specs32/prolight/README.md

# prolight
Gyroscope Matrix Flashlight

click the wiki button in the menu above ! ;)
