specs32/prolight/REV11/BLENDER/btncap_array_good_1.stl

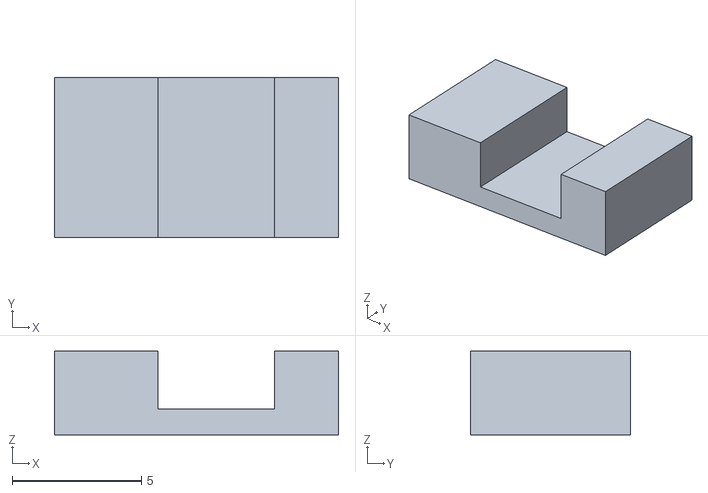
[picture p1: CAD file, 2018-05-02, an earlier design]
REV11/BLENDER/btncap_array_good_1.stl
11.0 x 6.20 x 3.25
