specs32/prolight/REV11/BLENDER/prolight25.stl

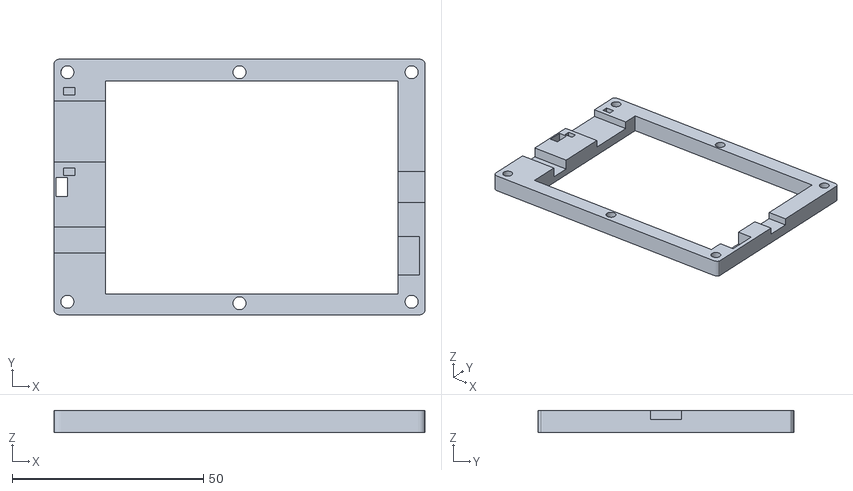
[picture p2: CAD file, 2018-05-02, an earlier design]
REV11/BLENDER/prolight25.stl
97.0 x 67.0 x 5.80
