specs32/prolight/(list of files, cad)

Other CAD files:
REV11/BLENDER/prolight25.blend
REV14/BLENDER/prolight27_w_buttons.blend
