specs32/prolight/REV14/changelog.md

//////////////////////////////////
changelog for the prolight REV 14 
//////////////////////////////////

- PE2 button removed - 3 way switch removed because of bad bad quality. (replaced with two good micro switches.) 

- oled circuit fixed and repositioned

- power mosfets fixed
