specs32/prolight/REV11/KICAD/eside_rev11/pdf/modular_eside_rev11.pdf

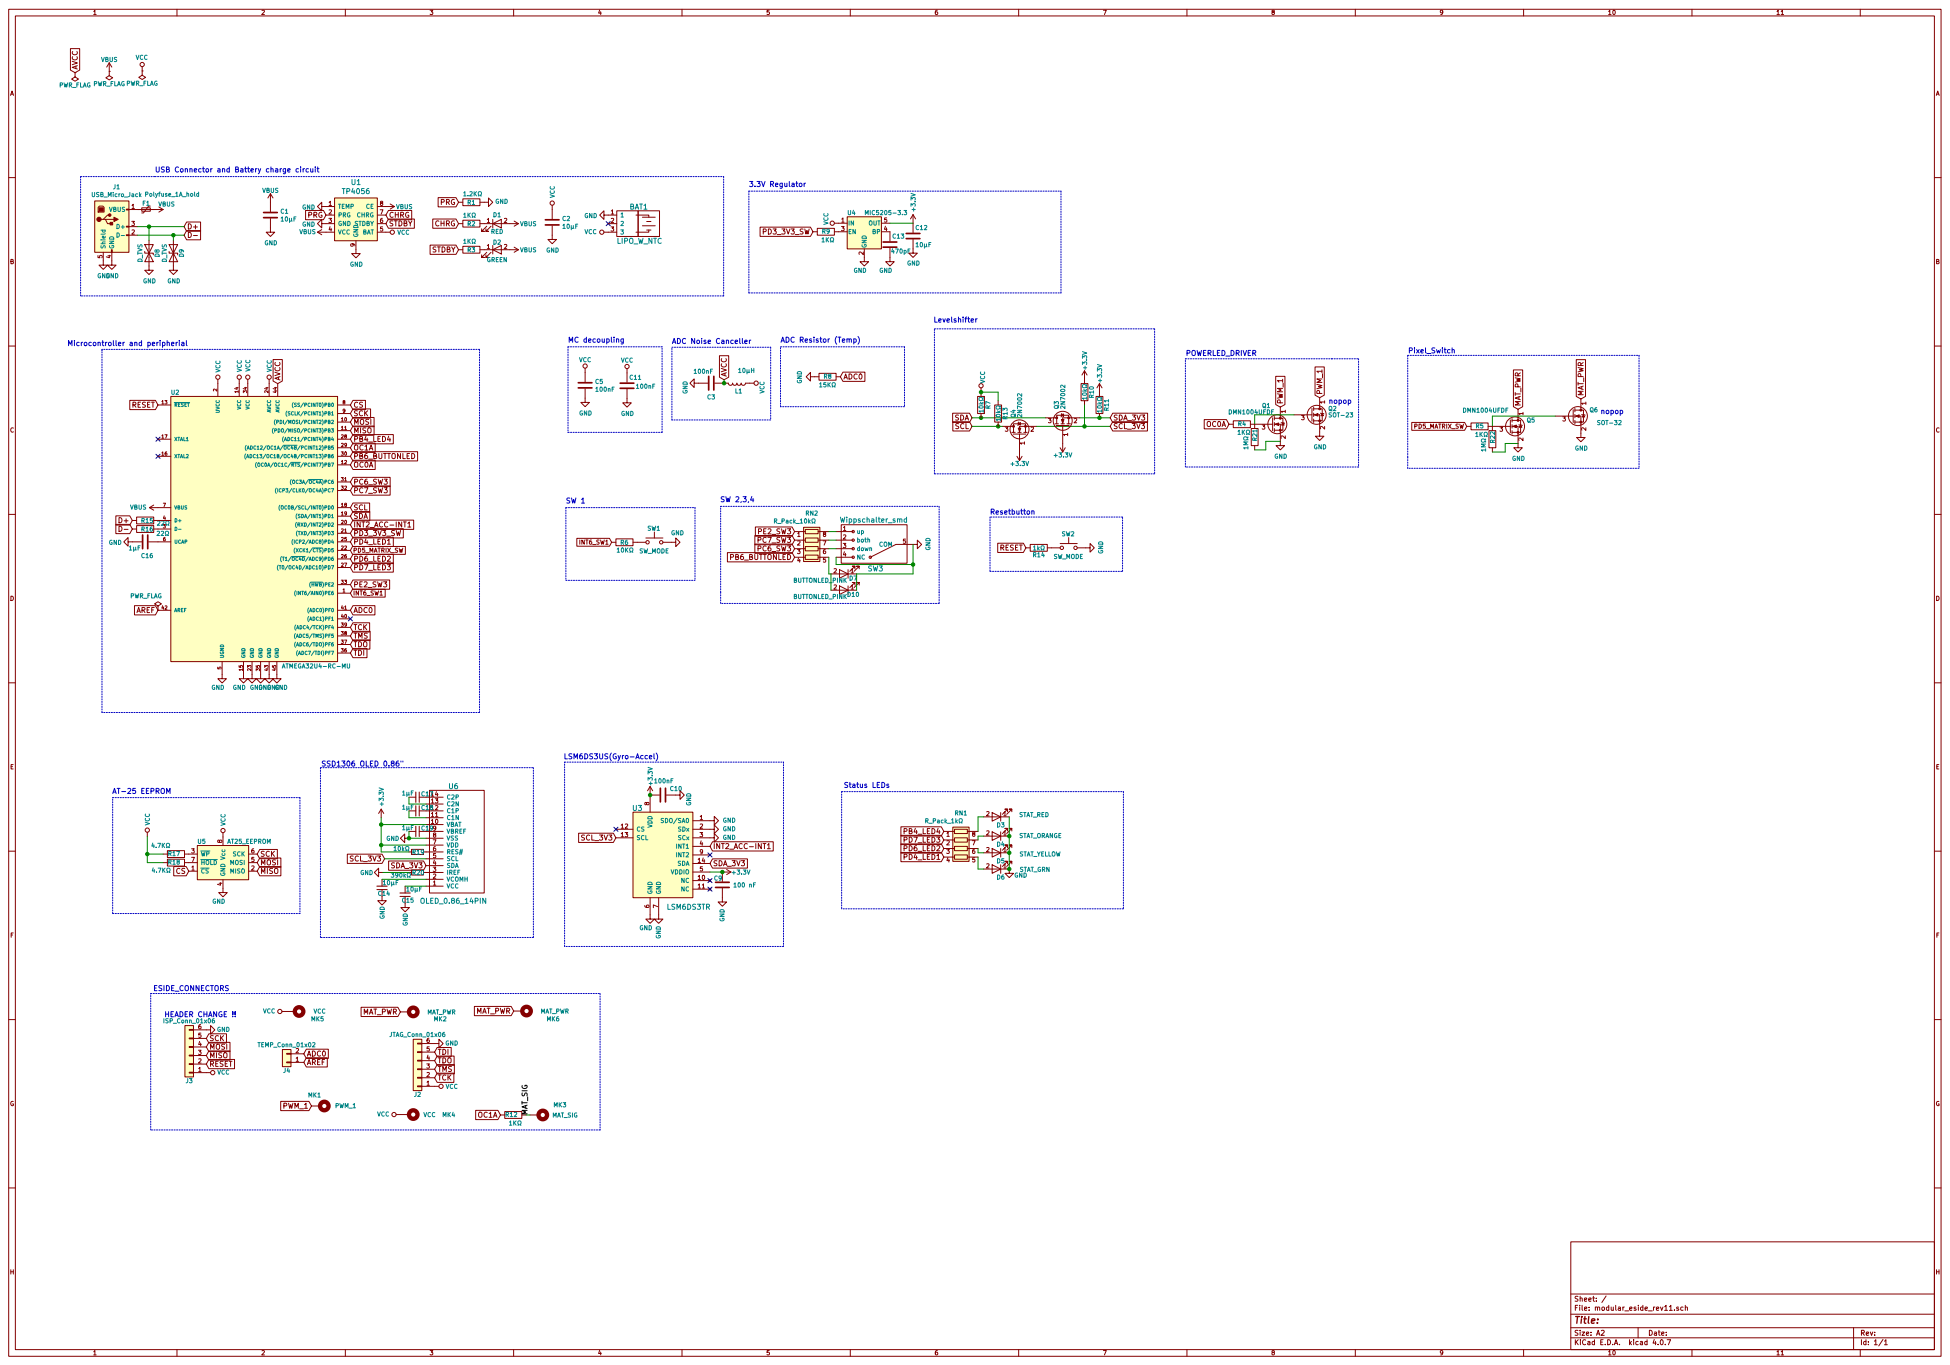
[picture p3: page 1]
