specs32/prolight/REV14/KICAD/eside_rev14/modular_eside_rev14.kicad_pcb

## KiCad design REV14/KICAD/eside_rev14/modular_eside_rev14.kicad_pcb (2018-05-02)

Schematic: modular_eside_rev14.sch

Parts:
BAT1: LIPO_W_NTC; CONN_AVX_RT_ANGLE_3pin_2.5mm_pitch
C1, C2, C12: 10µF; C_0805_HandSoldering
C3: 100nF; C_0805_HandSoldering
C4, C6, C14: 4.7µF; C_0805_HandSoldering
C5, C7, C10, C11, C18: 100nF; C_0603_HandSoldering
C8: 2.2µF; C_0805_HandSoldering
C9: 100 nF; C_0603_HandSoldering
C13: 470pF; C_0603_HandSoldering
C15, C16, C17: 1µF; C_0805_HandSoldering
D1: RED; LED_0603_HandSoldering
D2: GREEN; LED_0603_HandSoldering
D3: STAT_RED; LED_0603_HandSoldering
D4: STAT_YELLOW; LED_0603_HandSoldering
D5: STAT_GREEN; LED_0603_HandSoldering
D6: STAT_PINK; LED_0603_HandSoldering
D7, D10: BUTTONLED_PINK; LED_0603_HandSoldering
D8, D9: D_TVS; C_0603_HandSoldering
D11: LL4148; D_MiniMELF
F1: Polyfuse_1A_hold; C_0805_HandSoldering
J1: USB_Micro_Jack; Conn_USBmicro-B_ebay-side_TH_GROUND
J2: JTAG_Conn_01x06; Conn_01x06_SMD_2mm
J3: ISP_Conn_01x06; Conn_01x06_SMD_2mm
J4: TEMP_Conn_01x02; Pin_Header_Straight_1x02_Pitch2.00mm
L1: 10µH; C_0805_HandSoldering
MK1: PWM_1; MountingHole_2.2mm_M2_Pad
MK2, MK6: MAT_PWR; MountingHole_2.2mm_M2_Pad
MK3: MAT_SIG; MountingHole_2.2mm_M2_Pad
MK4, MK5: VCC; MountingHole_2.2mm_M2_Pad
Q1, Q5: DMN1004UFDF; U-DFN2020-6-smallerpads
Q2, Q6: Q_NMOS_GSD; SOT-23
Q3, Q4: 2N7002; SOT-23
R1: 1.2KΩ; R_0805_HandSoldering
R2, R3, R4, R5, R9, R12, R24: 1KΩ; R_0805_HandSoldering
R6, R19, R20: 10KΩ; R_0805_HandSoldering
R7, R10, R11, R13: 10kΩ; R_0805_HandSoldering
R8: 15KΩ; R_1210_HandSoldering
R14: 1kΩ; R_0805_HandSoldering
R15, R16: 22Ω; R_0805_HandSoldering
R17, R18: 4.7KΩ; R_0805_HandSoldering
R21, R22, R23: 1MΩ; R_0805_HandSoldering
R25: 4.7kΩ; R_0805_HandSoldering
R26: 380kΩ; R_0805_HandSoldering
R27: 0Ω; R_1206_HandSoldering
RN1: R_Pack_1kΩ; R_Array_Convex_4x0603
SW1: SW_MODE; white_nano_smd_switch
SW2: SW_MODE; SW_SPST_FSMSM
SW3: SW_UP; white_nano_smd_switch
SW4: SW_DOWN; white_nano_smd_switch
U1: TP4056; SOIC-8-1EP_3.9x4.9mm_Pitch1.27mm
U2: ATMEGA32U4-RC-MU; QFN-44-1EP_7x7mm_Pitch0.5mm
U3: LSM6DS3TR; LGA-14L_2.5x3mm__LSM6DS3; MPN LSM6DS3TR; Digi-Key_PN 497-15383-1-ND
U4: MIC5205-3.3; SOT-23-5
U5: AT25_EEPROM; SOIC-8_3.9x4.9mm_Pitch1.27mm
U6: OLED_0.86_14PIN; OLED_0.86_14pin_i2c

Connections:
/MAT_SIG: MK3.1, R12.2
ADC0: J4.2, R8.2, U2.41 ((ADC0)PF0)
AREF: J4.1, U2.42 (AREF)
AVCC: C3.1, L1.2, U2.44 (AVCC)
CHRG: R2.2, U1.7
CS: U2.8 ((SS/PCINT0)PB0), U5.1 (~CS)
D+: D8.1 (A1), J1.3, R15.2
D-: D9.1 (A1), J1.2, R16.2
GND: BAT1.1, C1.2, C2.2, C3.2, C4.1, C5.2, C6.2, C7.2, C8.1, C9.2, C10.2, C11.2, C12.2, C13.2, C14.2, C16.2, C18.2, D3.1, D4.1, D5.1, D6.1, D7.1, D8.2 (A2), D9.2 (A2), D10.1, J1.4, J1.5, J2.6, J3.6, Q1.2 (S), Q2.2 (S), Q5.2 (S), Q6.2 (S), R1.1, R8.1, R21.2, R22.2, R23.2, R26.2, SW1.2, SW2.2, SW3.2, SW4.2, U1.1, U1.3, U1.9, U2.5 (UGND), U2.15 (GND), U2.23 (GND), U2.35 (GND), U2.43 (GND), U2.45 (GND), U3.1 (SDO/SA0), U3.2 (SDx), U3.3 (SCx), U3.6 (GND), U3.7 (GND), U4.2, U5.4 (GND), U6.7 (VSS)
INT2_ACC-INT1: U2.20 ((RXD/INT2)PD2), U3.4 (INT1)
INT6_SW1: R6.2, U2.1 ((INT6/AIN0)PE6)
MAT_PWR: MK2.1, MK6.1, Q5.1 (D), Q6.3 (D)
MISO: J3.3, U2.11 ((PDO/MISO/PCINT3)PB3), U5.2 (MISO)
MOSI: J3.4, U2.10 ((PDI/MOSI/PCINT2)PB2), U5.5 (MOSI)
unnamed: C4.2, R27.2, U6.9 (RES#)
unnamed: C8.2, U6.13 (VCOMH)
unnamed: C13.1, U4.4
unnamed: C14.1, C18.1, U6.14 (VCC)
unnamed: C15.1, U6.1 (C2P)
unnamed: C15.2, U6.2 (C2N)
unnamed: C16.1, U2.6 (UCAP)
unnamed: C17.1, U6.3 (C1P)
unnamed: C17.2, U6.4 (C1N)
unnamed: D1.1, R2.1
unnamed: D2.1, R3.1
unnamed: D3.2, RN1.8
unnamed: D4.2, RN1.7
unnamed: D5.2, RN1.6
unnamed: D6.2, RN1.5
unnamed: D7.2, D10.2, R24.2
unnamed: D11.2 (A), R25.1, R27.1
unnamed: F1.2, J1.1
unnamed: Q1.3 (G), Q2.1 (G), R4.2, R21.1
unnamed: Q5.3 (G), Q6.1 (G), R5.2, R22.1
unnamed: R6.1, SW1.1
unnamed: R14.1, SW2.1
unnamed: R15.1, U2.4 (D+)
unnamed: R16.1, U2.3 (D-)
unnamed: R17.2, U5.3 (~WP)
unnamed: R18.2, U5.7 (~HOLD)
unnamed: R19.1, SW3.1
unnamed: R20.1, SW4.1
unnamed: R9.2, R23.1, U4.3
unnamed: R26.1, U6.12 (IREF)
OC1A: R12.1, U2.29 ((ADC12/OC1A/~OC4B~/PCINT12)PB5)
OC1C: R4.1, U2.12 ((OC0A/OC1C/~RTS~/PCINT7)PB7)
PB4_LED4: RN1.1, U2.28 ((ADC11/PCINT4)PB4)
PB6_BUTTONLED: R24.1, U2.30 ((ADC13/OC1B/OC4B/PCINT13)PB6)
PC6_SW3: R20.2, U2.31 ((OC3A/~OC4A~)PC6)
PC7_SW3: R19.2, U2.32 ((ICP3/CLK0/OC4A)PC7)
PD3_3V3_SW: R9.1, U2.21 ((TXD/INT3)PD3)
PD4_LED1: RN1.4, U2.25 ((ICP2/ADC8)PD4)
PD5_MATRIX_SW: R5.1, U2.22 ((XCK1/~CTS~)PD5)
PD6_LED2: RN1.3, U2.26 ((T1/~OC4D~/ADC9)PD6)
PD7_LED3: RN1.2, U2.27 ((T0/OC4D/ADC10)PD7)
PRG: R1.2, U1.2
PWM_1: MK1.1, Q1.1 (D), Q2.3 (D)
RESET: J3.2, R14.2, U2.13 (~RESET~)
SCK: J3.5, U2.9 ((SCLK/PCINT1)PB1), U5.6 (SCK)
SCL: Q4.3, R13.2, U2.18 ((OC0B/SCL/INT0)PD0)
SCL_3V3: Q4.2, R10.2, U3.13 (SCL), U6.10 (SCL)
SDA: Q3.3, R7.2, U2.19 ((SDA/INT1)PD1)
SDA_3V3: Q3.2, R11.2, U3.14 (SDA), U6.11 (SDA)
STDBY: R3.2, U1.6
TCK: J2.2, U2.39 ((ADC4/TCK)PF4)
TDI: J2.5, U2.36 ((ADC7/TDI)PF7)
TDO: J2.4, U2.37 ((ADC6/TDO)PF6)
TMS: J2.3, U2.38 ((ADC5/TMS)PF5)
VBUS: C1.1, D1.2, D2.2, F1.1, U1.4, U1.8, U2.7 (VBUS)
VCC: BAT1.3, C2.1, C5.1, C11.1, J2.1, J3.1, L1.1, MK4.1, MK5.1, R7.1, R13.1, R17.1, R18.1, U1.5, U2.2 (UVCC), U2.14 (VCC), U2.24 (AVCC), U2.34 (VCC), U4.1, U5.8 (Vcc)

Notes on the sheet:
USB Connector and Battery charge circuit
Microcontroller and peripherial
POWER SW (INT 6)
ADC Resistor (Temp)
MC decoupling
Status LEDs
ESIDE_CONNECTORS
ADC Noise Canceller
POWERLED_DRIVER
3.3V Regulator
Levelshifter
SW UP / DOWN
AT-25 EEPROM
SSD1306 OLED
HEADER CHANGE !!
LSM6DS3US(Gyro-Accel)
Pixel_Switch
nopop
Resetbutton
kicad powerflags

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
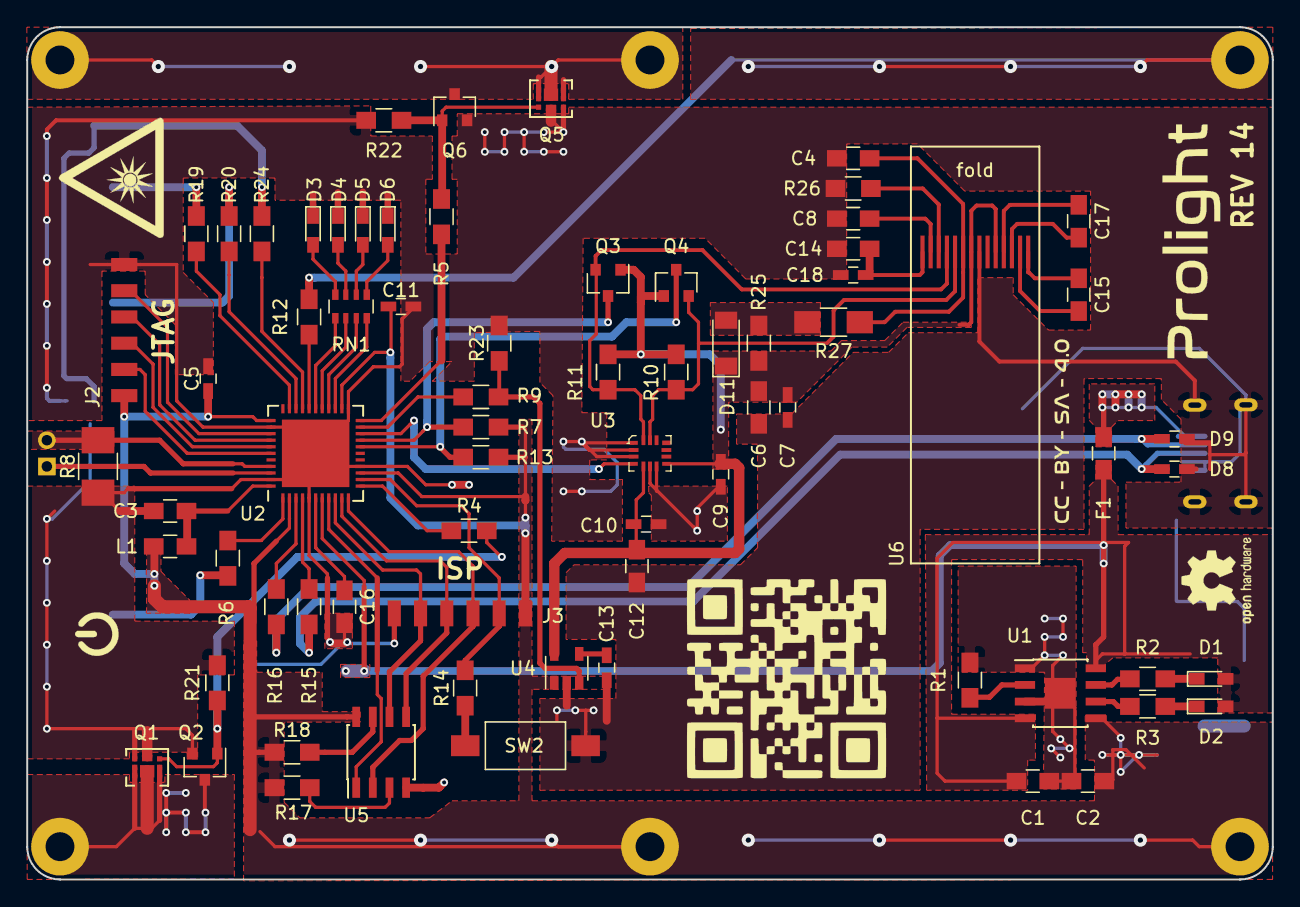
[picture p4: board modular_eside_rev14.kicad_pcb from above]

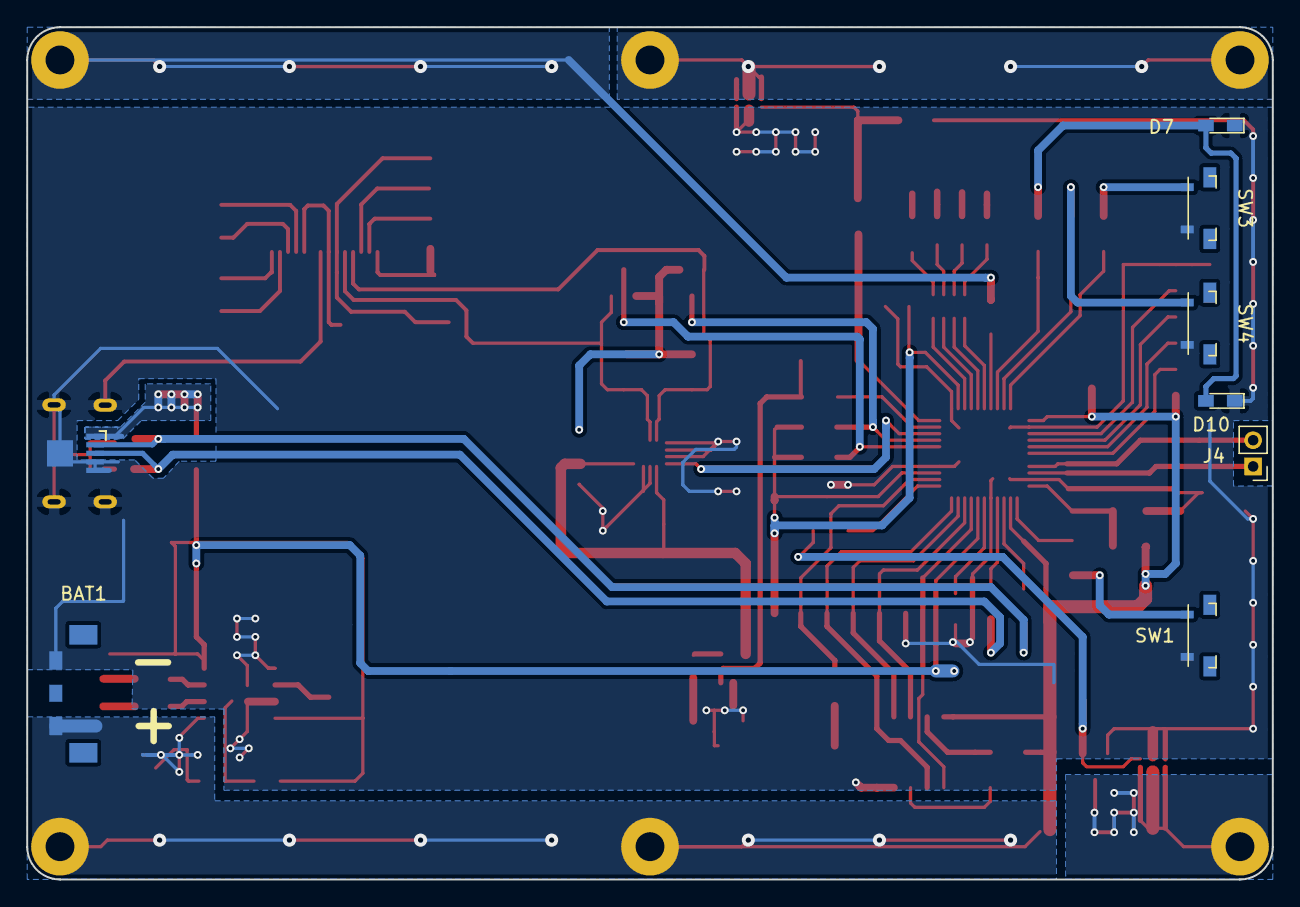
[picture p5: board modular_eside_rev14.kicad_pcb from below]

Board: 2 copper layers, 95.0 x 65.0 mm, 86 parts (8 on the bottom side), 71 nets.
