specs32/prolight/REV14/KICAD/matrix_rev14/modular_matrix_rev14.kicad_pcb

## KiCad design REV14/KICAD/matrix_rev14/modular_matrix_rev14.kicad_pcb (2018-05-02)

Schematic: modular_matrix_rev14.sch

Parts:
C1, C2, C3, C4, C5, C7, C8, C9, C10, C11, C13, C14, C15, C16, C17, C19, C20, C21, C22, C23, C24, C25, C26, C27, C28, C29, C30, C31, C32, C33, C34, C35, C36, C37, C38, C39, C40, C41, C42, C43, C44, C45, C46, C47, C48, C49, C50, C51, C52, C53, C54, C55, C56, C57: 100nF; C_1206
D1, D2, D3: LED_oslon_ssl80; LED_osram_oslon_ssl_powerled
J1: Conn_01x02_Male; Pin_Header_Straight_1x02_Pitch2.00mm
MK1: VCC; MountingHole_2.2mm_M2_Pad
MK2: OC1A; MountingHole_2.2mm_M2_Pad
MK3, MK5: GND; MountingHole_2.2mm_M2_Pad
MK4: PWM_1; MountingHole_2.2mm_M2_Pad
MK6: VCC_OPT; MountingHole_2.2mm_M2_Pad
R1: 10KΩ NTC; R_0805_HandSoldering
U1, U2, U3, U4, U5, U6, U7, U8, U9, U10, U11, U12, U13, U14, U15, U16, U17, U18, U19, U20, U21, U22, U23, U24, U25, U26, U27, U28, U29, U30, U31, U32, U33, U34, U35, U36, U37, U38, U39, U40, U41, U42, U43, U44, U45, U46, U47, U48, U52, U53, U54, U55, U56, U57, U58, U59, U60, U61, U62, U63, U64, U65, U66: RGB_ws2812_3535; SK6812_3535

Connections:
GND: C1.2, C2.2, C3.2, C4.2, C5.2, C7.2, C8.2, C9.2, C10.2, C11.2, C13.2, C14.2, C15.2, C16.2, C17.2, C19.2, C20.2, C21.2, C22.2, C23.2, C24.2, C25.2, C26.2, C27.2, C28.2, C29.2, C30.2, C31.2, C32.2, C33.2, C34.2, C35.2, C36.2, C37.2, C38.2, C39.2, C40.2, C41.2, C42.2, C43.2, C44.2, C45.2, C46.2, C47.2, C48.2, C49.2, C50.2, C51.2, C52.2, C53.2, C54.2, C55.2, C56.2, C57.2, MK3.1, MK5.1, U1.2 (GND), U2.2 (GND), U3.2 (GND), U4.2 (GND), U5.2 (GND), U6.2 (GND), U7.2 (GND), U8.2 (GND), U9.2 (GND), U10.2 (GND), U11.2 (GND), U12.2 (GND), U13.2 (GND), U14.2 (GND), U15.2 (GND), U16.2 (GND), U17.2 (GND), U18.2 (GND), U19.2 (GND), U20.2 (GND), U21.2 (GND), U22.2 (GND), U23.2 (GND), U24.2 (GND), U25.2 (GND), U26.2 (GND), U27.2 (GND), U28.2 (GND), U29.2 (GND), U30.2 (GND), U31.2 (GND), U32.2 (GND), U33.2 (GND), U34.2 (GND), U35.2 (GND), U36.2 (GND), U37.2 (GND), U38.2 (GND), U39.2 (GND), U40.2 (GND), U41.2 (GND), U42.2 (GND), U43.2 (GND), U44.2 (GND), U45.2 (GND), U46.2 (GND), U47.2 (GND), U48.2 (GND), U52.2 (GND), U53.2 (GND), U54.2 (GND), U55.2 (GND), U56.2 (GND), U57.2 (GND), U58.2 (GND), U59.2 (GND), U60.2 (GND), U61.2 (GND), U62.2 (GND), U63.2 (GND), U64.2 (GND), U65.2 (GND), U66.2 (GND)
unnamed: J1.1, R1.1
unnamed: J1.2, R1.2
unnamed: U1.1 (DOUT), U59.3 (DIN)
unnamed: U1.3 (DIN), U2.1 (DOUT)
unnamed: U2.3 (DIN), U3.1 (DOUT)
unnamed: U3.3 (DIN), U4.1 (DOUT)
unnamed: U4.3 (DIN), U5.1 (DOUT)
unnamed: U5.3 (DIN), U6.1 (DOUT)
unnamed: U6.3 (DIN), U60.1 (DOUT)
unnamed: U7.3 (DIN), U8.1 (DOUT)
unnamed: U8.3 (DIN), U9.1 (DOUT)
unnamed: U9.3 (DIN), U10.1 (DOUT)
unnamed: U10.3 (DIN), U11.1 (DOUT)
unnamed: U11.3 (DIN), U12.1 (DOUT)
unnamed: U12.3 (DIN), U61.1 (DOUT)
unnamed: U13.1 (DOUT), U61.3 (DIN)
unnamed: U13.3 (DIN), U14.1 (DOUT)
unnamed: U14.3 (DIN), U15.1 (DOUT)
unnamed: U15.3 (DIN), U16.1 (DOUT)
unnamed: U16.3 (DIN), U17.1 (DOUT)
unnamed: U17.3 (DIN), U18.1 (DOUT)
unnamed: U18.3 (DIN), U62.1 (DOUT)
unnamed: U19.1 (DOUT), U62.3 (DIN)
unnamed: U19.3 (DIN), U20.1 (DOUT)
unnamed: U20.3 (DIN), U21.1 (DOUT)
unnamed: U21.3 (DIN), U22.1 (DOUT)
unnamed: U22.3 (DIN), U23.1 (DOUT)
unnamed: U23.3 (DIN), U24.1 (DOUT)
unnamed: U24.3 (DIN), U63.1 (DOUT)
unnamed: U25.1 (DOUT), U63.3 (DIN)
unnamed: U25.3 (DIN), U26.1 (DOUT)
unnamed: U26.3 (DIN), U27.1 (DOUT)
unnamed: U27.3 (DIN), U28.1 (DOUT)
unnamed: U28.3 (DIN), U29.1 (DOUT)
unnamed: U29.3 (DIN), U30.1 (DOUT)
unnamed: U30.3 (DIN), U64.1 (DOUT)
unnamed: U31.1 (DOUT), U64.3 (DIN)
unnamed: U31.3 (DIN), U32.1 (DOUT)
unnamed: U32.3 (DIN), U33.1 (DOUT)
unnamed: U33.3 (DIN), U34.1 (DOUT)
unnamed: U34.3 (DIN), U35.1 (DOUT)
unnamed: U35.3 (DIN), U36.1 (DOUT)
unnamed: U36.3 (DIN), U65.1 (DOUT)
unnamed: U37.1 (DOUT), U65.3 (DIN)
unnamed: U37.3 (DIN), U38.1 (DOUT)
unnamed: U38.3 (DIN), U39.1 (DOUT)
unnamed: U39.3 (DIN), U40.1 (DOUT)
unnamed: U40.3 (DIN), U41.1 (DOUT)
unnamed: U41.3 (DIN), U42.1 (DOUT)
unnamed: U42.3 (DIN), U66.1 (DOUT)
unnamed: U43.1 (DOUT), U66.3 (DIN)
unnamed: U43.3 (DIN), U44.1 (DOUT)
unnamed: U44.3 (DIN), U45.1 (DOUT)
unnamed: U45.3 (DIN), U46.1 (DOUT)
unnamed: U46.3 (DIN), U47.1 (DOUT)
unnamed: U47.3 (DIN), U48.1 (DOUT)
unnamed: U52.1 (DOUT), U58.3 (DIN)
unnamed: U52.3 (DIN), U53.1 (DOUT)
unnamed: U53.3 (DIN), U54.1 (DOUT)
unnamed: U54.3 (DIN), U55.1 (DOUT)
unnamed: U55.3 (DIN), U56.1 (DOUT)
unnamed: U56.3 (DIN), U57.1 (DOUT)
unnamed: U57.3 (DIN), U59.1 (DOUT)
unnamed: U7.1 (DOUT), U60.3 (DIN)
OC1A: MK2.1, U48.3 (DIN)
PWM_1: D1.1 (K), D2.1 (K), D3.1 (K), MK4.1
VCC: C1.1, C2.1, C3.1, C4.1, C5.1, C7.1, C8.1, C9.1, C10.1, C11.1, C13.1, C14.1, C15.1, C16.1, C17.1, C19.1, C20.1, C21.1, C22.1, C23.1, C24.1, C25.1, C26.1, C27.1, C28.1, C29.1, C30.1, C31.1, C32.1, C33.1, C34.1, C35.1, C36.1, C37.1, C38.1, C39.1, C40.1, C41.1, C42.1, C43.1, C44.1, C45.1, C46.1, C47.1, C48.1, C49.1, C50.1, C51.1, C52.1, C53.1, C54.1, C55.1, C56.1, C57.1, D1.2 (A), D2.2 (A), D3.2 (A), MK1.1, MK6.1, U1.4 (VCC), U2.4 (VCC), U3.4 (VCC), U4.4 (VCC), U5.4 (VCC), U6.4 (VCC), U7.4 (VCC), U8.4 (VCC), U9.4 (VCC), U10.4 (VCC), U11.4 (VCC), U12.4 (VCC), U13.4 (VCC), U14.4 (VCC), U15.4 (VCC), U16.4 (VCC), U17.4 (VCC), U18.4 (VCC), U19.4 (VCC), U20.4 (VCC), U21.4 (VCC), U22.4 (VCC), U23.4 (VCC), U24.4 (VCC), U25.4 (VCC), U26.4 (VCC), U27.4 (VCC), U28.4 (VCC), U29.4 (VCC), U30.4 (VCC), U31.4 (VCC), U32.4 (VCC), U33.4 (VCC), U34.4 (VCC), U35.4 (VCC), U36.4 (VCC), U37.4 (VCC), U38.4 (VCC), U39.4 (VCC), U40.4 (VCC), U41.4 (VCC), U42.4 (VCC), U43.4 (VCC), U44.4 (VCC), U45.4 (VCC), U46.4 (VCC), U47.4 (VCC), U48.4 (VCC), U52.4 (VCC), U53.4 (VCC), U54.4 (VCC), U55.4 (VCC), U56.4 (VCC), U57.4 (VCC), U58.4 (VCC), U59.4 (VCC), U60.4 (VCC), U61.4 (VCC), U62.4 (VCC), U63.4 (VCC), U64.4 (VCC), U65.4 (VCC), U66.4 (VCC)

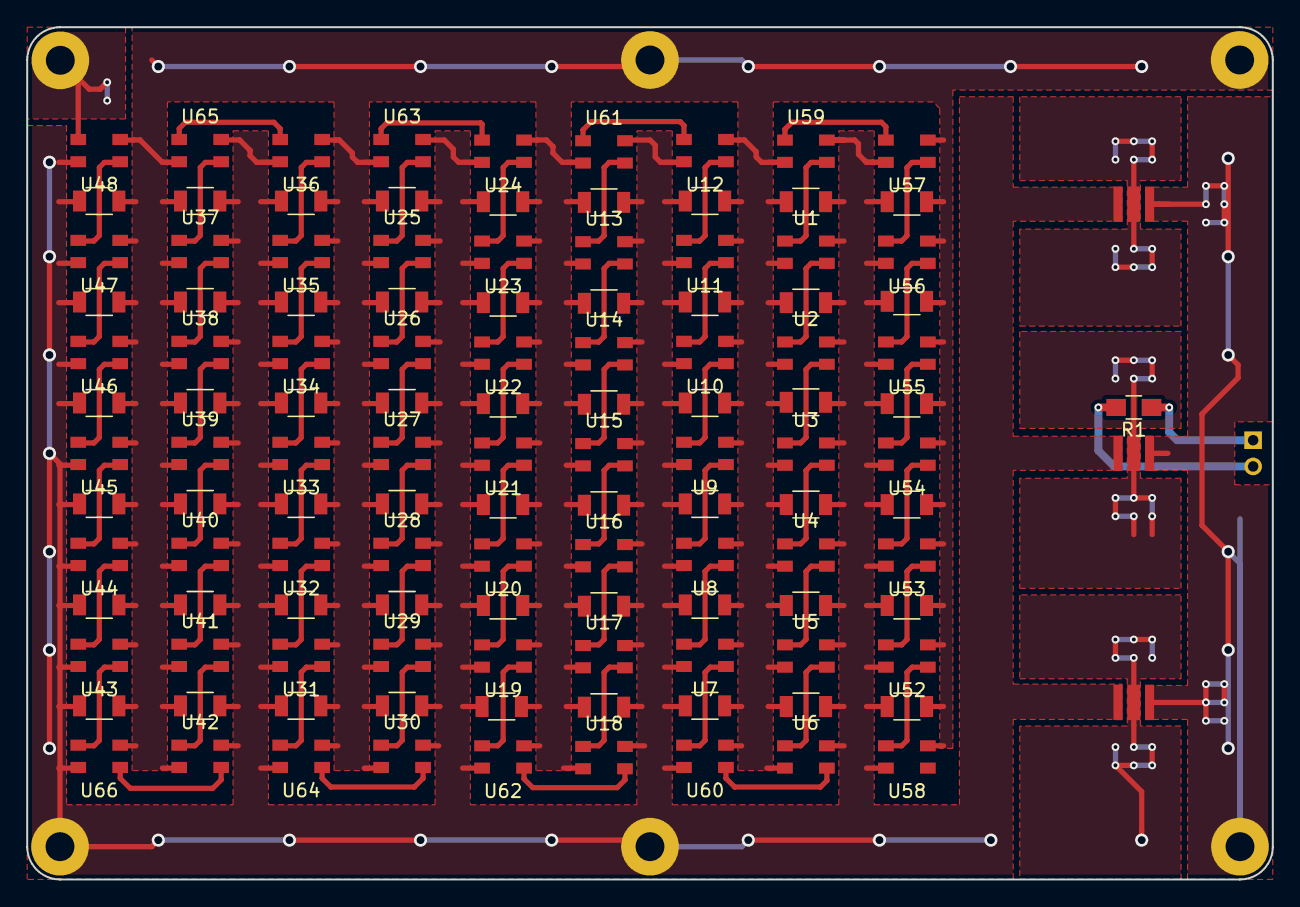
[picture p6: board modular_matrix_rev14.kicad_pcb from above]

Board: 2 copper layers, 95.0 x 65.0 mm, 128 parts (1 on the bottom side), 68 nets.
