specs32/prolight/(commit log)

2018-04-27 initial release
    WIP !
    bare minimum to run the light, check temps, and voltages and power down
2018-05-01 added some gyro stuff
    added reinit twi after sleep
    added levels (matrix gyro)
    few other minor corretions
2018-05-02 pushed REV 14
    [modular_eside_rev14-B.Cu.gbr, modular_eside_rev14-B.Mask.gbr, modular_eside_rev14-B.SilkS.gbr, modular_eside_rev14-Edge.Cuts.gbr, modular_eside_rev14-F.Cu.gbr, modular_eside_rev14-F.Mask.gbr, modular_eside_rev14-F.SilkS.gbr, modular_eside_rev14.drl]
2018-05-02 added changes for the prolight
    [btncap_array_good_1.stl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]
2018-05-12 all fine so far...
    external SPI flash still needs implementation
